TorBorve/Drone-Launcher/(threads)

Thread 10 (2023-08-07):

Manual control

TorBorve, 2023-08-07:
Make topic for controlling servos manually without checking any safety stuff. Could be useful if something is not working propperly.

TorBorve, 2023-08-10:
fixed

Closed 2023-08-10.
