TorBorve/Drone-Launcher/electronics/drone_launcher.kicad_pcb

## KiCad design electronics/drone_launcher.kicad_pcb (2023-07-11)

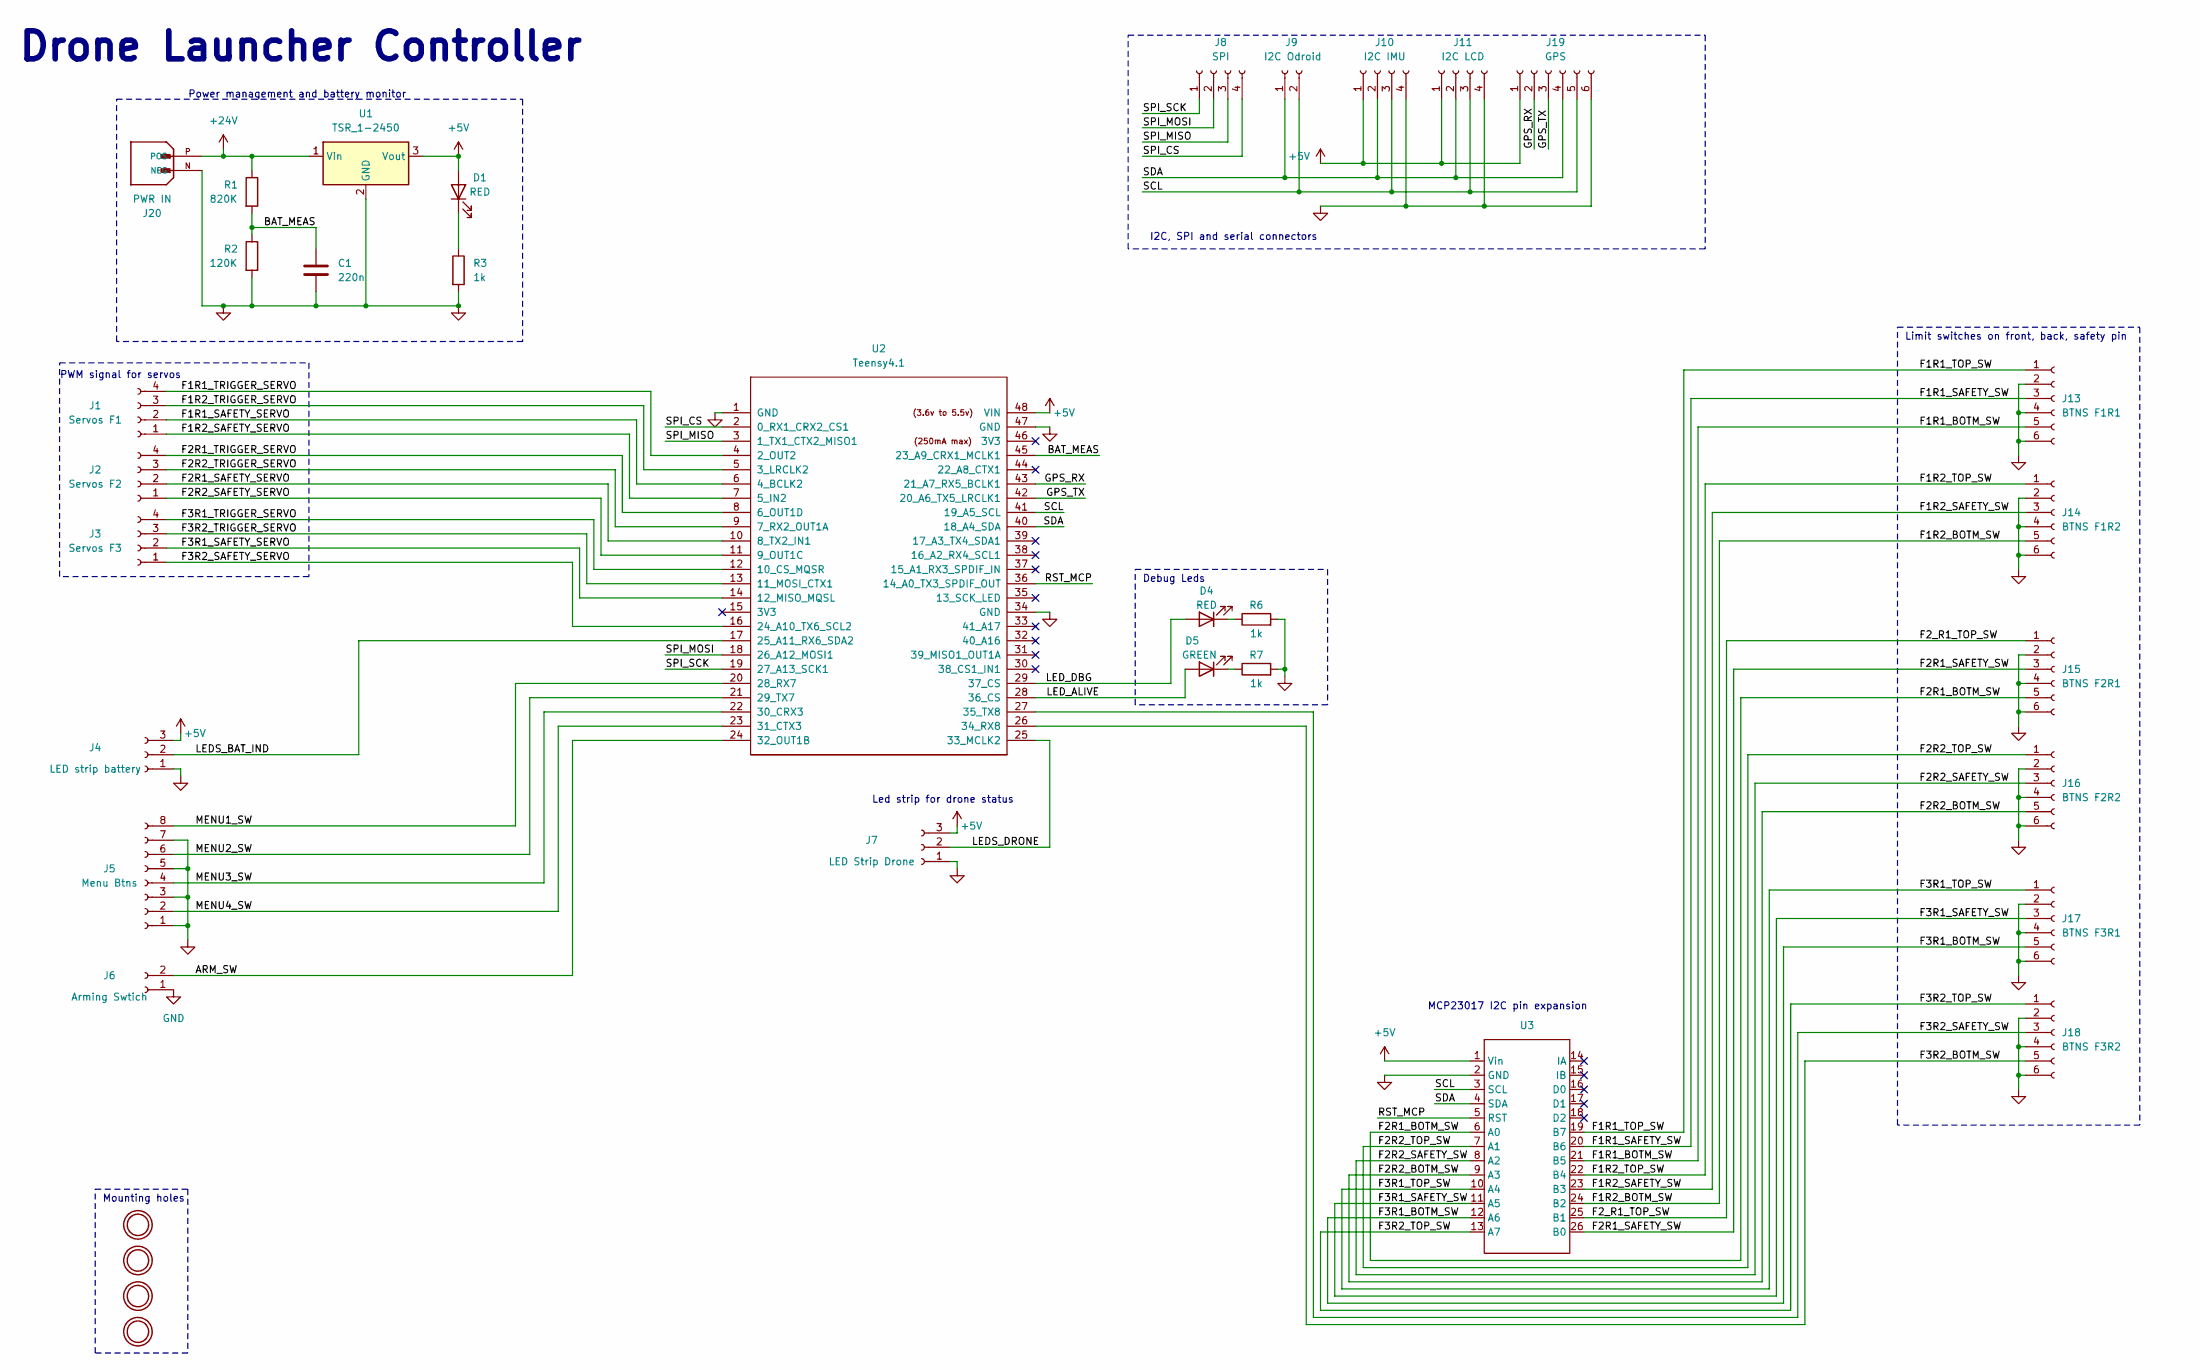
[picture p4: schematic drone_launcher.kicad_sch, Drone Launcher Controller]

Parts:
C1: 220n; C_1206_3216Metric
D1, D4: RED; LED_1206_3216Metric
D5: GREEN; LED_1206_3216Metric
J1: Servos F1; JST_XH_B4B-XH-A_1x04_P2.50mm_Vertical
J2: Servos F2; JST_XH_B4B-XH-A_1x04_P2.50mm_Vertical
J3: Servos F3; JST_XH_B4B-XH-A_1x04_P2.50mm_Vertical
J4: LED strip battery; JST_XH_B3B-XH-A_1x03_P2.50mm_Vertical
J5: Menu Btns; JST_XH_B8B-XH-A_1x08_P2.50mm_Vertical
J6: Arming Swtich; JST_XH_B2B-XH-A_1x02_P2.50mm_Vertical
J7: LED Strip Drone; JST_XH_B3B-XH-A_1x03_P2.50mm_Vertical
J8: SPI; JST_XH_B4B-XH-A_1x04_P2.50mm_Vertical
J9: I2C Odroid; JST_XH_B2B-XH-A_1x02_P2.50mm_Vertical
J10: I2C IMU; JST_XH_B4B-XH-A_1x04_P2.50mm_Vertical
J11: I2C LCD; JST_XH_B4B-XH-A_1x04_P2.50mm_Vertical
J13: BTNS F1R1; JST_XH_B6B-XH-A_1x06_P2.50mm_Vertical
J14: BTNS F1R2; JST_XH_B6B-XH-A_1x06_P2.50mm_Vertical
J15: BTNS F2R1; JST_XH_B6B-XH-A_1x06_P2.50mm_Vertical
J16: BTNS F2R2; JST_XH_B6B-XH-A_1x06_P2.50mm_Vertical
J17: BTNS F3R1; JST_XH_B6B-XH-A_1x06_P2.50mm_Vertical
J18: BTNS F3R2; JST_XH_B6B-XH-A_1x06_P2.50mm_Vertical
J19: GPS; JST_XH_B6B-XH-A_1x06_P2.50mm_Vertical
J20: PWR IN; AMASS_XT60-M; PARTREV V1.2
MH1, MH2, MH3, MH4: MountingHole_3.2mm_M3
R1: 820K; R_1206_3216Metric
R2: 120K; R_1206_3216Metric
R3, R6, R7: 1k; R_1206_3216Metric
U1: TSR_1-2450; Converter_DCDC_TRACO_TSR-1_THT
U2: Teensy4.1; Teensy41
U3: Adafruit_MCP23017_Breakout

Connections:
+5V: D1.2 (A), J4.3, J7.3, J10.1, J11.1, J19.1, U1.3 (Vout), U2.48 (VIN), U3.1 (Vin)
+24V: J20.P (POS), R1.1, U1.1 (Vin)
/ARM_SW: J6.2, U2.24 (32_OUT1B)
/BAT_MEAS: C1.1, R1.2, R2.1, U2.45 (23_A9_CRX1_MCLK1)
/F1R1_BOTM_SW: J13.5, U3.21 (B5)
/F1R1_SAFETY_SERVO: J1.2, U2.6 (4_BCLK2)
/F1R1_SAFETY_SW: J13.3, U3.20 (B6)
/F1R1_TOP_SW: J13.1, U3.19 (B7)
/F1R1_TRIGGER_SERVO: J1.4, U2.4 (2_OUT2)
/F1R2_BOTM_SW: J14.5, U3.24 (B2)
/F1R2_SAFETY_SERVO: J1.1, U2.7 (5_IN2)
/F1R2_SAFETY_SW: J14.3, U3.23 (B3)
/F1R2_TOP_SW: J14.1, U3.22 (B4)
/F1R2_TRIGGER_SERVO: J1.3, U2.5 (3_LRCLK2)
/F2R1_BOTM_SW: J15.5, U3.6 (A0)
/F2R1_SAFETY_SERVO: J2.2, U2.10 (8_TX2_IN1)
/F2R1_SAFETY_SW: J15.3, U3.26 (B0)
/F2R1_TRIGGER_SERVO: J2.4, U2.8 (6_OUT1D)
/F2R2_BOTM_SW: J16.5, U3.9 (A3)
/F2R2_SAFETY_SERVO: J2.1, U2.11 (9_OUT1C)
/F2R2_SAFETY_SW: J16.3, U3.8 (A2)
/F2R2_TOP_SW: J16.1, U3.7 (A1)
/F2R2_TRIGGER_SERVO: J2.3, U2.9 (7_RX2_OUT1A)
/F2_R1_TOP_SW: J15.1, U3.25 (B1)
/F3R1_BOTM_SW: J17.5, U3.12 (A6)
/F3R1_SAFETY_SERVO: J3.2, U2.14 (12_MISO_MQSL)
/F3R1_SAFETY_SW: J17.3, U3.11 (A5)
/F3R1_TOP_SW: J17.1, U3.10 (A4)
/F3R1_TRIGGER_SERVO: J3.4, U2.12 (10_CS_MQSR)
/F3R2_BOTM_SW: J18.5, U2.26 (34_RX8)
/F3R2_SAFETY_SERVO: J3.1, U2.16 (24_A10_TX6_SCL2)
/F3R2_SAFETY_SW: J18.3, U2.27 (35_TX8)
/F3R2_TOP_SW: J18.1, U3.13 (A7)
/F3R2_TRIGGER_SERVO: J3.3, U2.13 (11_MOSI_CTX1)
/GPS_RX: J19.2, U2.43 (21_A7_RX5_BCLK1)
/GPS_TX: J19.3, U2.42 (20_A6_TX5_LRCLK1)
/LEDS_BAT_IND: J4.2, U2.17 (25_A11_RX6_SDA2)
/LEDS_DRONE: J7.2, U2.25 (33_MCLK2)
/LED_ALIVE: D5.2 (A), U2.28 (36_CS)
/LED_DBG: D4.2 (A), U2.29 (37_CS)
/MENU1_SW: J5.8, U2.20 (28_RX7)
/MENU2_SW: J5.6, U2.21 (29_TX7)
/MENU3_SW: J5.4, U2.22 (30_CRX3)
/MENU4_SW: J5.2, U2.23 (31_CTX3)
/RST_MCP: U2.36 (14_A0_TX3_SPDIF_OUT), U3.5 (RST)
/SCL: J9.2, J10.3, J11.3, J19.5, U2.41 (19_A5_SCL), U3.3 (SCL)
/SDA: J9.1, J10.2, J11.2, J19.4, U2.40 (18_A4_SDA), U3.4 (SDA)
/SPI_CS: J8.4, U2.2 (0_RX1_CRX2_CS1)
/SPI_MISO: J8.3, U2.3 (1_TX1_CTX2_MISO1)
/SPI_MOSI: J8.2, U2.18 (26_A12_MOSI1)
/SPI_SCK: J8.1, U2.19 (27_A13_SCK1)
GND: C1.2, J4.1, J5.1, J5.3, J5.5, J5.7, J6.1, J7.1, J10.4, J11.4, J13.2, J13.4, J13.6, J14.2, J14.4, J14.6, J15.2, J15.4, J15.6, J16.2, J16.4, J16.6, J17.2, J17.4, J17.6, J18.2, J18.4, J18.6, J19.6, J20.N (NEG), R2.2, R3.2, R6.2, R7.2, U1.2 (GND), U2.1 (GND), U2.34 (GND), U2.47 (GND), U3.2 (GND)
unnamed: D1.1 (K), R3.1
unnamed: D4.1 (K), R6.1
unnamed: D5.1 (K), R7.1

Notes on the sheet:
PWM signal for servos
Drone Launcher Controller
Mounting holes
Led strip for drone status
I2C, SPI and serial connectors
Power management and battery monitor
Limit switches on front, back, safety pin
Debug Leds
MCP23017 I2C pin expansion

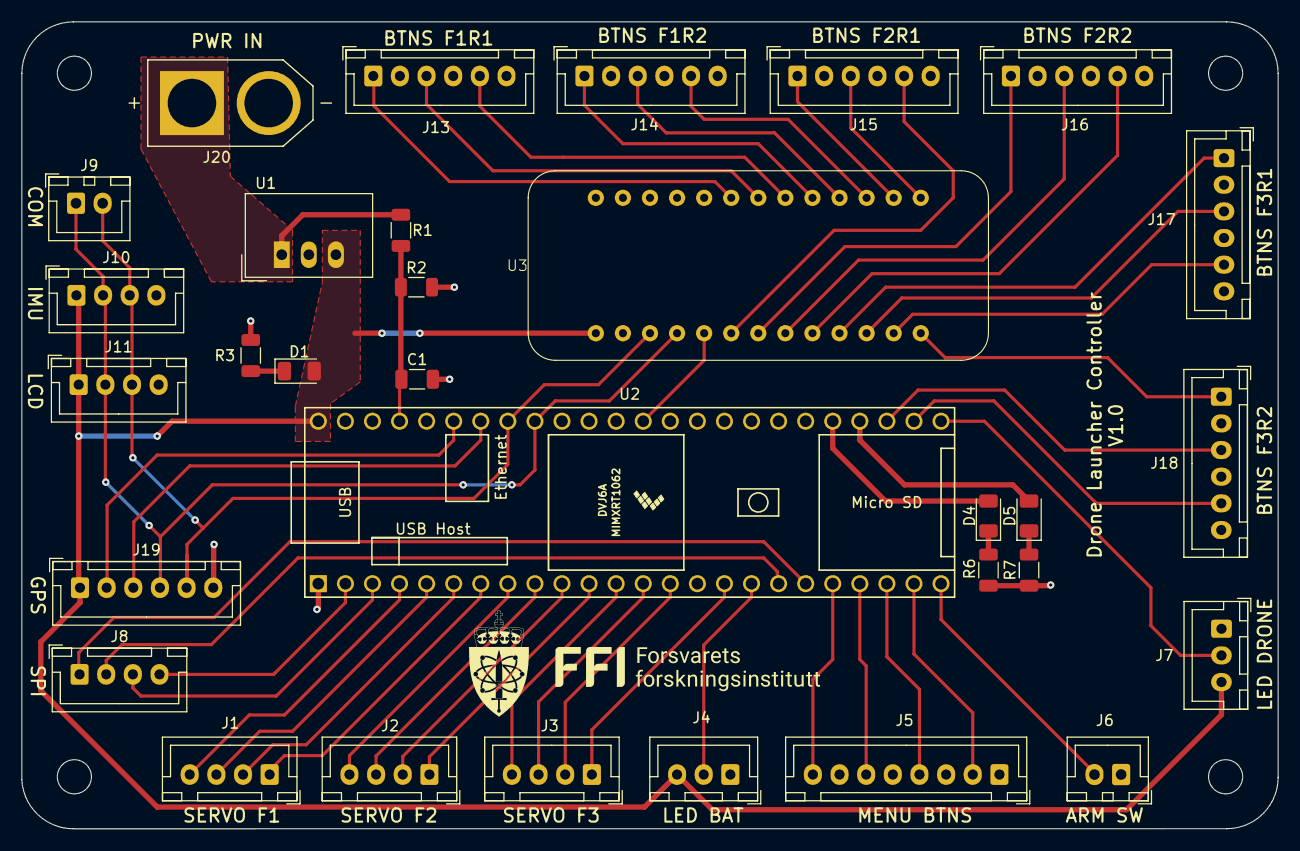
[picture p5: board drone_launcher.kicad_pcb from above]

Board: 2 copper layers, 117.9 x 75.7 mm, 35 parts (0 on the bottom side), 55 nets.
