TorBorve/Drone-Launcher/(commit log)

2023-06-27 simple button class
2023-07-07 added electrical files
    [drone_launcher.kicad_pcb, drone_launcher.kicad_sch]
2023-07-07 added mcp23017 footprint and 3D model
2023-07-07 added labels and initial pcb layout
    [drone_launcher.kicad_pcb, drone_launcher.kicad_sch]
2023-07-10 fixed pin numbering
2023-07-10 improved routing and new footprints
    [drone_launcher.kicad_pcb, drone_launcher.kicad_sch]
2023-07-11 version 1.0 pcb
    [drone_launcher.kicad_pcb, drone_launcher.kicad_sch]
2023-07-11 added gbr files
    [drone_launcher-B_Cu.gbr, drone_launcher-B_Mask.gbr, drone_launcher-B_Paste.gbr, drone_launcher-B_Silkscreen.gbr, drone_launcher-Edge_Cuts.gbr, drone_launcher-F_Cu.gbr, drone_launcher-F_Mask.gbr, drone_launcher-F_Paste.gbr]
2023-07-13 using teensy 4.1
2023-07-13 updated button and switch class
2023-07-13 threads and more for launch unit
2023-07-14 added led classes
2023-07-14 Leds synchronized blinking
2023-07-14 added use of MCP expansion board
2023-07-14 added init functions to avoid issues with mcp pins
    [Buttons.cpp, Buttons.h, LaunchUnit.cpp, LaunchUnit.h, Leds.cpp, Leds.h, main.cpp]
2023-07-14 fixed included multiple error
    [Pins.cpp, Pins.h, main.cpp]
2023-07-14 bug, bias not used
    [Buttons.cpp]
2023-07-18 Added battery monitor files to monitor battery
2023-07-18 added all pin mappings
2023-07-18 using pin mappings and leds
2023-07-19 fixed redef of pins
    [Pins.h]
2023-07-19 Implemented battery monitoring class
2023-07-19 Added accurate battery voltage range
2023-07-19 fixed bugs and code quality
    [BatteryMonitor.cpp, BatteryMonitor.h]
2023-07-20 using battery monitor
2023-08-02 testing and fixing bugs
    [LaunchSystem.cpp, LaunchSystem.h, LaunchUnit.cpp, Menu.cpp, Pins.cpp, Pins.h, main.cpp]
2023-08-03 shit fix mirrored servos
    [LaunchSystem.cpp, LaunchUnit.cpp, LaunchUnit.h]
2023-08-03 fixed retracting servo on startup bug
    [LaunchUnit.cpp, LaunchUnit.h]
2023-08-04 fixed range of IDs available
    [LaunchSystem.cpp, Menu.cpp]
2023-08-04 started on IMU
2023-08-07 fixed GPS fix and correct serial port
    [Communicator.cpp, Navigator.cpp, Navigator.h]
2023-08-07 fixes #1 (to some degree)
    [BatteryMonitor.cpp, BatteryMonitor.h, Communicator.cpp, LaunchSystem.cpp, LaunchSystem.h, Menu.cpp, Menu.h, Navigator.cpp]
2023-08-08 fixed small bugs and testing
    [Communicator.cpp, LaunchUnit.cpp, LaunchUnit.h, Navigator.cpp, main.cpp]
